dangrie158/NixieClock/Hardware/FrontPanel-IN14.brd

## EAGLE design Hardware/FrontPanel-IN14.brd (2020-01-01)

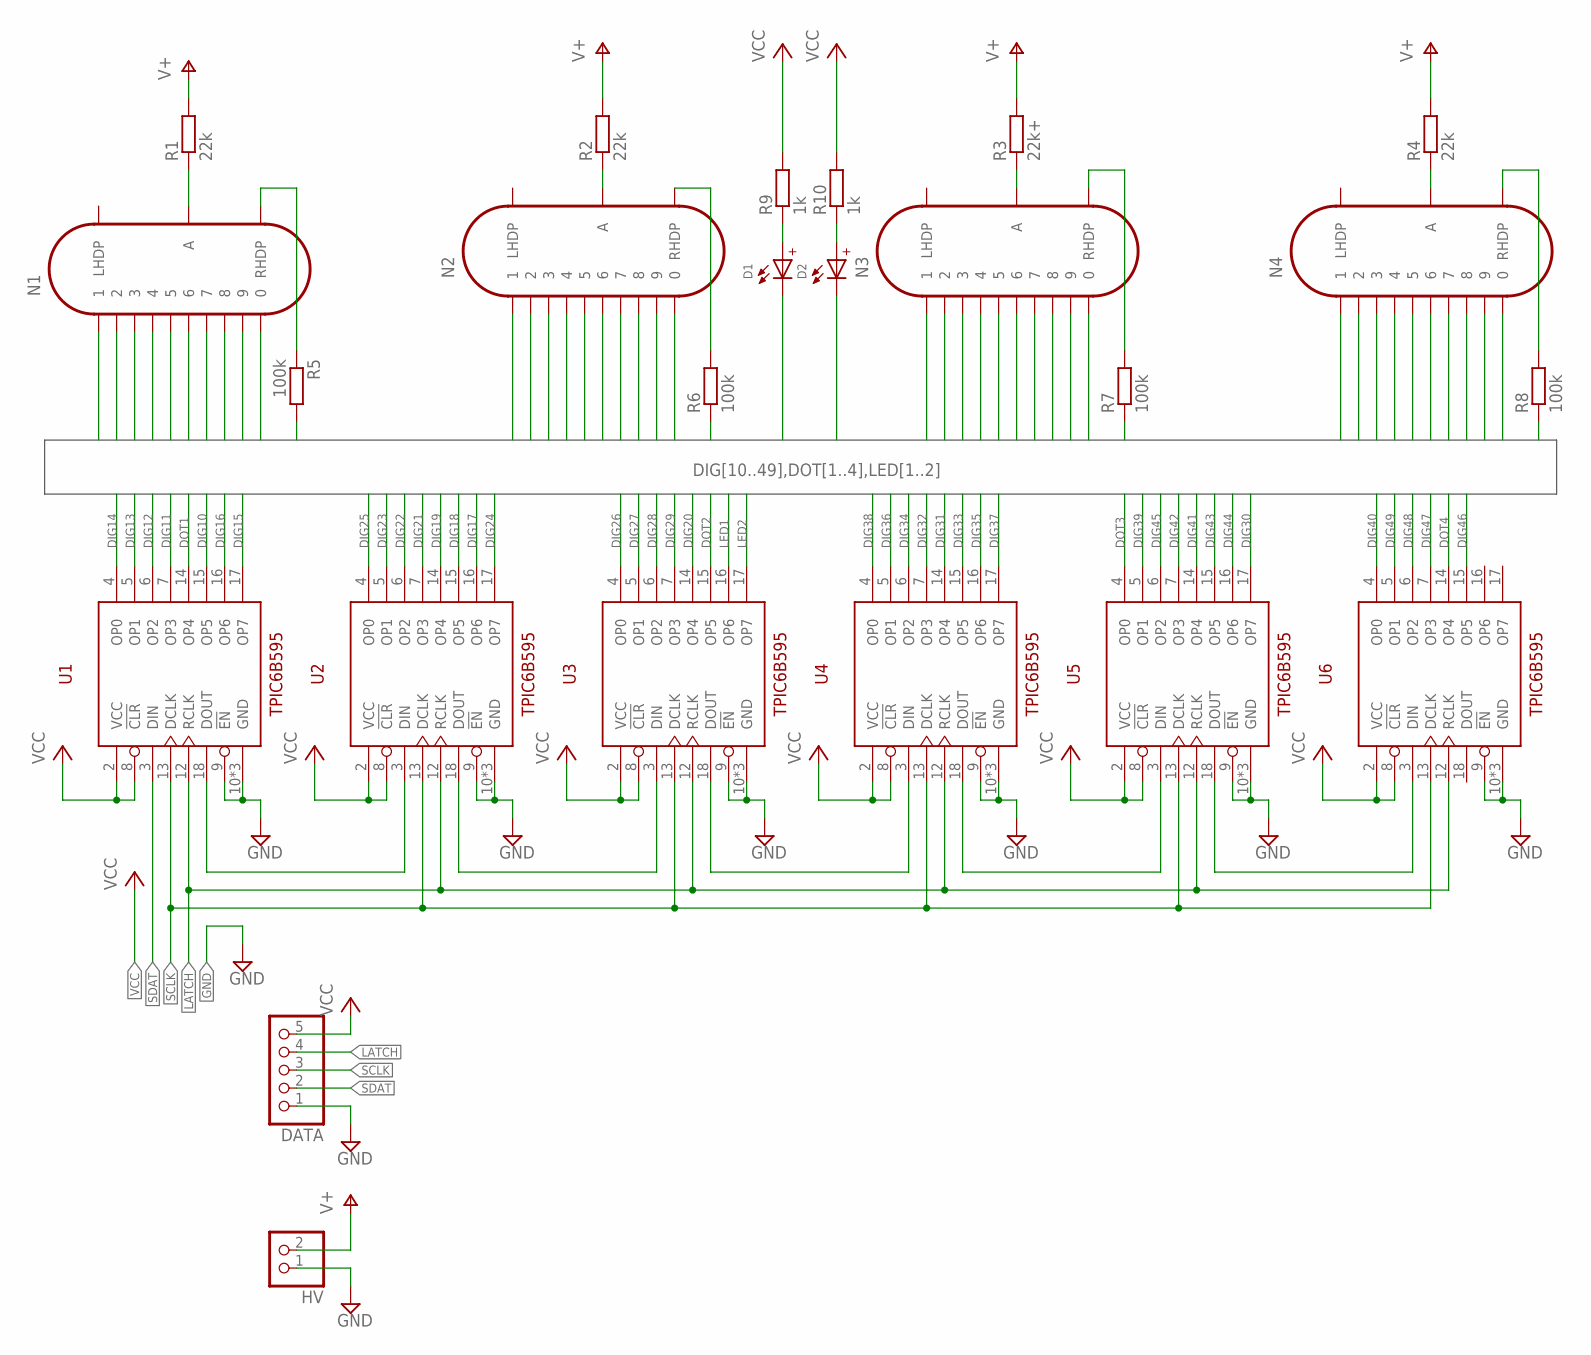
[picture p1: schematic FrontPanel-IN14.sch]

Parts:
D1, D2: RED/AMBER; WL-SITW_154141XXBA210
DATA: .1" Header; 1X05
HV: .1" Header; 1X02
N1, N2, N3, N4: IN-14
R1, R2, R4: 22k; 0207/10
R3: 22k+; 0207/10
R5, R6, R7, R8: 100k; 0207/10
R9, R10: 1k; 0207/10
U1, U2, U3, U4, U5, U6: TPIC6B595N; PDIP-20

Connections:
DIG10: N1.0, U1.15 (OP5)
DIG11: N1.1, U1.7 (OP3)
DIG12: N1.2, U1.6 (OP2)
DIG13: N1.3, U1.5 (OP1)
DIG14: N1.4, U1.4 (OP0)
DIG15: N1.5, U1.17 (OP7)
DIG16: N1.6, U1.16 (OP6)
DIG17: N1.7, U2.16 (OP6)
DIG18: N1.8, U2.15 (OP5)
DIG19: N1.9, U2.14 (OP4)
DIG20: N2.0, U3.14 (OP4)
DIG21: N2.1, U2.7 (OP3)
DIG22: N2.2, U2.6 (OP2)
DIG23: N2.3, U2.5 (OP1)
DIG24: N2.4, U2.17 (OP7)
DIG25: N2.5, U2.4 (OP0)
DIG26: N2.6, U3.4 (OP0)
DIG27: N2.7, U3.5 (OP1)
DIG28: N2.8, U3.6 (OP2)
DIG29: N2.9, U3.7 (OP3)
DIG30: N3.0, U5.17 (OP7)
DIG31: N3.1, U4.14 (OP4)
DIG32: N3.2, U4.7 (OP3)
DIG33: N3.3, U4.15 (OP5)
DIG34: N3.4, U4.6 (OP2)
DIG35: N3.5, U4.16 (OP6)
DIG36: N3.6, U4.5 (OP1)
DIG37: N3.7, U4.17 (OP7)
DIG38: N3.8, U4.4 (OP0)
DIG39: N3.9, U5.5 (OP1)
DIG40: N4.0, U6.4 (OP0)
DIG41: N4.1, U5.14 (OP4)
DIG42: N4.2, U5.7 (OP3)
DIG43: N4.3, U5.15 (OP5)
DIG44: N4.4, U5.16 (OP6)
DIG45: N4.5, U5.6 (OP2)
DIG46: N4.6, U6.15 (OP5)
DIG47: N4.7, U6.7 (OP3)
DIG48: N4.8, U6.6 (OP2)
DIG49: N4.9, U6.5 (OP1)
DOT1: R5.2, U1.14 (OP4)
DOT2: R6.1, U3.15 (OP5)
DOT3: R7.1, U5.4 (OP0)
DOT4: R8.1, U6.14 (OP4)
GND: DATA.1, HV.1, U1.9 (!EN), U1.10 (GND), U1.11 (GND), U1.19 (GND), U2.9 (!EN), U2.10 (GND), U2.11 (GND), U2.19 (GND), U3.9 (!EN), U3.10 (GND), U3.11 (GND), U3.19 (GND), U4.9 (!EN), U4.10 (GND), U4.11 (GND), U4.19 (GND), U5.9 (!EN), U5.10 (GND), U5.11 (GND), U5.19 (GND), U6.9 (!EN), U6.10 (GND), U6.11 (GND), U6.19 (GND)
LATCH: DATA.4, U1.12 (RCLK), U2.12 (RCLK), U3.12 (RCLK), U4.12 (RCLK), U5.12 (RCLK), U6.12 (RCLK)
LED1: D1.2 (-), U3.16 (OP6)
LED2: D2.2 (-), U3.17 (OP7)
unnamed: N1.RHDP, R5.1
unnamed: N2.RHDP, R6.2
unnamed: N3.RHDP, R7.2
unnamed: N4.RHDP, R8.2
unnamed: N1.A, R1.1
unnamed: N2.A, R2.1
unnamed: N3.A, R3.1
unnamed: N4.A, R4.1
unnamed: U1.18 (DOUT), U2.3 (DIN)
unnamed: U2.18 (DOUT), U3.3 (DIN)
unnamed: U3.18 (DOUT), U4.3 (DIN)
unnamed: U4.18 (DOUT), U5.3 (DIN)
unnamed: U5.18 (DOUT), U6.3 (DIN)
unnamed: D1.1 (+), R9.1
unnamed: D2.1 (+), R10.1
SCLK: DATA.3, U1.13 (DCLK), U2.13 (DCLK), U3.13 (DCLK), U4.13 (DCLK), U5.13 (DCLK), U6.13 (DCLK)
SDAT: DATA.2, U1.3 (DIN)
V+: HV.2, R1.2, R2.2, R3.2, R4.2
VCC: DATA.5, R9.2, R10.2, U1.2 (VCC), U1.8 (!CLR), U2.2 (VCC), U2.8 (!CLR), U3.2 (VCC), U3.8 (!CLR), U4.2 (VCC), U4.8 (!CLR), U5.2 (VCC), U5.8 (!CLR), U6.2 (VCC), U6.8 (!CLR)

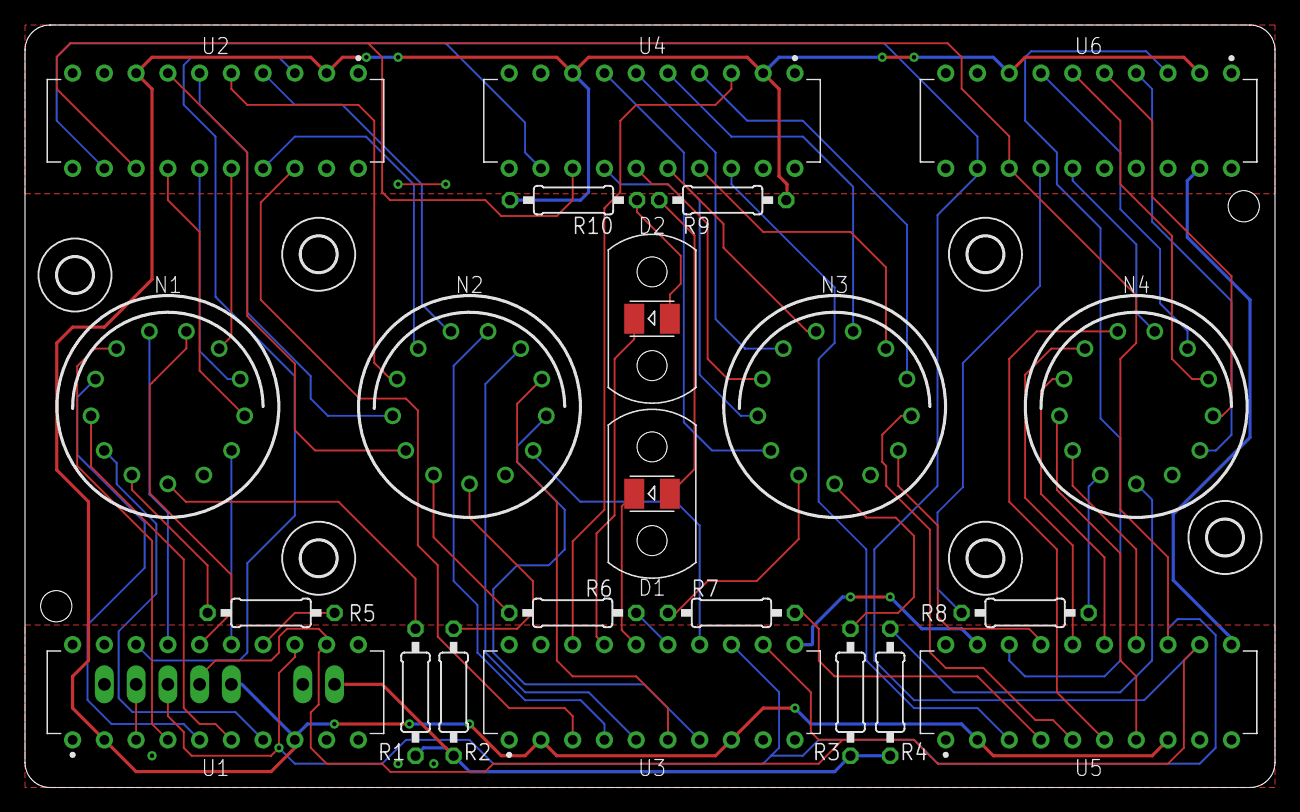
[picture p2: board FrontPanel-IN14.brd from above]

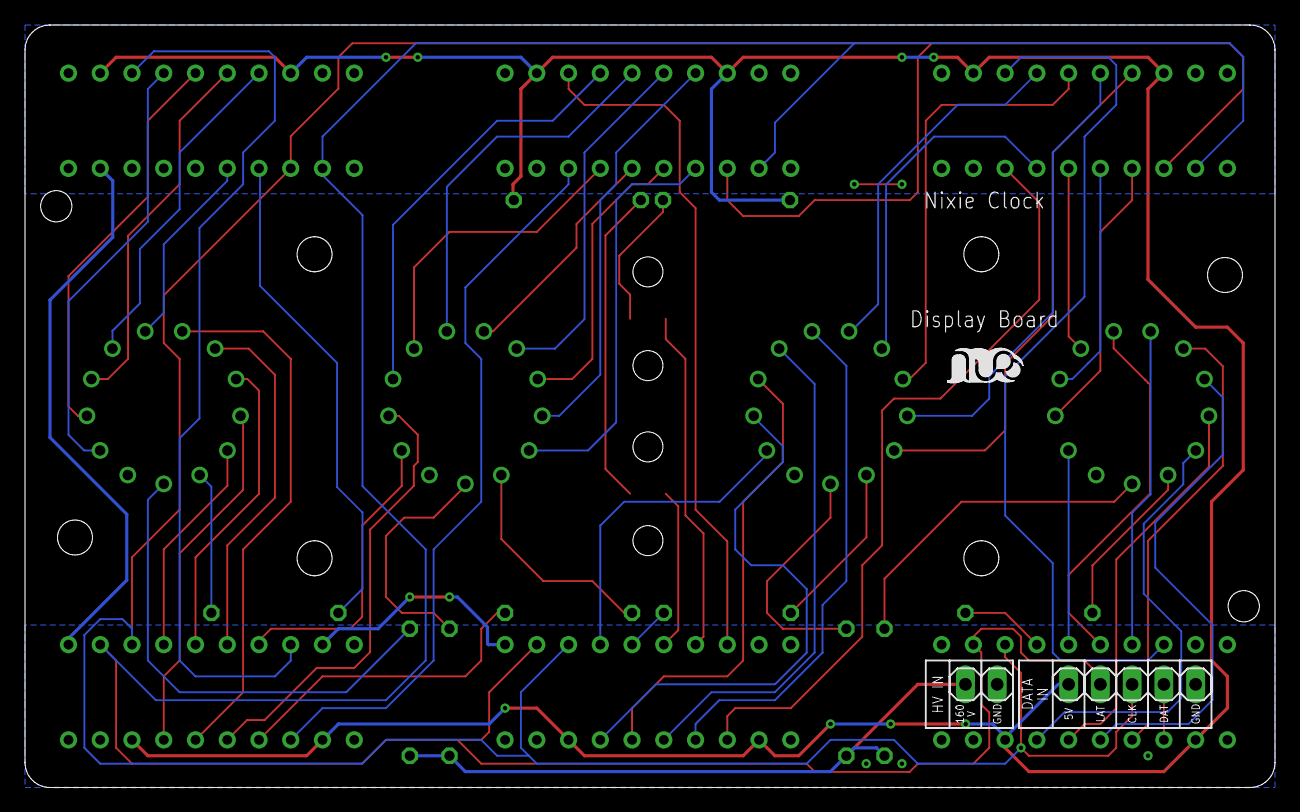
[picture p3: board FrontPanel-IN14.brd from below]

Board: 2 copper layers, 100.0 x 61.0 mm, 33 parts (3 on the bottom side), 67 nets.

Other parts of the board:
U$1, U$2, U$3, U$7, U$8, U$9: 2,8
U$4: LOGO-SILKSCREEEN-S
U$5, U$6: MENTOR-1216.1005
