dangrie158/NixieClock/Hardware/PowerSupply.brd

## EAGLE design Hardware/PowerSupply.brd (2018-12-29)

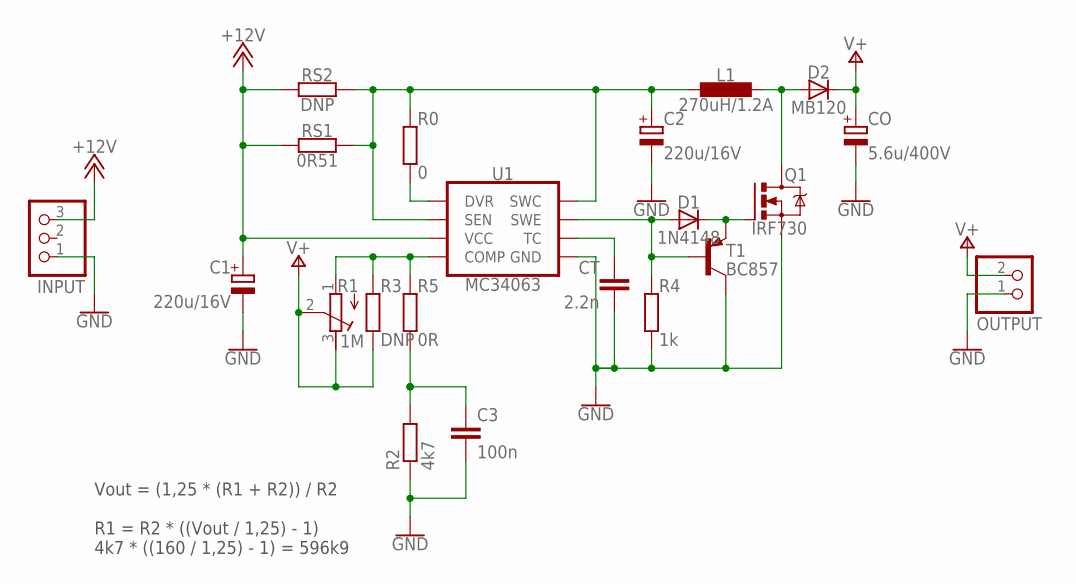
[picture p4: schematic PowerSupply.sch]

Parts:
C1, C2: 220u/16V; 140CLH-0810
C3: 100n; C0603K
CO: 5.6u/400V; 153CLV-1010
CT: 2.2n; C0603K
D1: 1N4148; SOD323-W
D2: MB120; DO214AA
INPUT: PINHD-1X3; 1X03
L1: 270uH/1.2A; TC-PIS4728
OUTPUT: PINHD-1X2; 1X02
Q1: IRF730; TO220BV
R0: 0; R0603
R1: 1M; RTRIM64W
R2: 4k7; R0603
R3: DNP; R0603
R4: 1k; R0603
R5: 0R; R0603
RS1: 0R51; R2512
RS2: DNP; R2512
T1: BC857; SOT23-BEC
U1: MC34063; SOIC127P600X175-8

Connections:
+12V: C1.+, INPUT.3, RS1.1, RS2.1, U1.6 (VCC)
GND: C1.-, C2.-, C3.2, CO.-, CT.1, INPUT.1, OUTPUT.1, Q1.S, R2.1, R4.1, T1.C, U1.4 (GND)
unnamed: D1.A, R4.2, T1.B, U1.2 (SWE)
unnamed: D1.C, Q1.G, T1.E
unnamed: R0.2, U1.8 (DVR)
unnamed: D2.A, L1.P$1 (1), Q1.D
unnamed: CT.2, U1.3 (TC)
unnamed: R1.1 (A), R3.2, R5.1, U1.5 (COMP)
unnamed: C3.1, R2.2, R5.2
unnamed: C2.+, L1.P$2 (2), R0.1, RS1.2, RS2.2, U1.1 (SWC), U1.7 (SEN)
V+: CO.+, D2.C, OUTPUT.2, R1.2 (S), R1.3 (E), R3.1

Notes on the sheet:
Vout = (1,25 * (R1 + R2)) / R2 R1 = R2 * ((Vout / 1,25) - 1) 4k7 * ((160 / 1,25) - 1) = 596k9

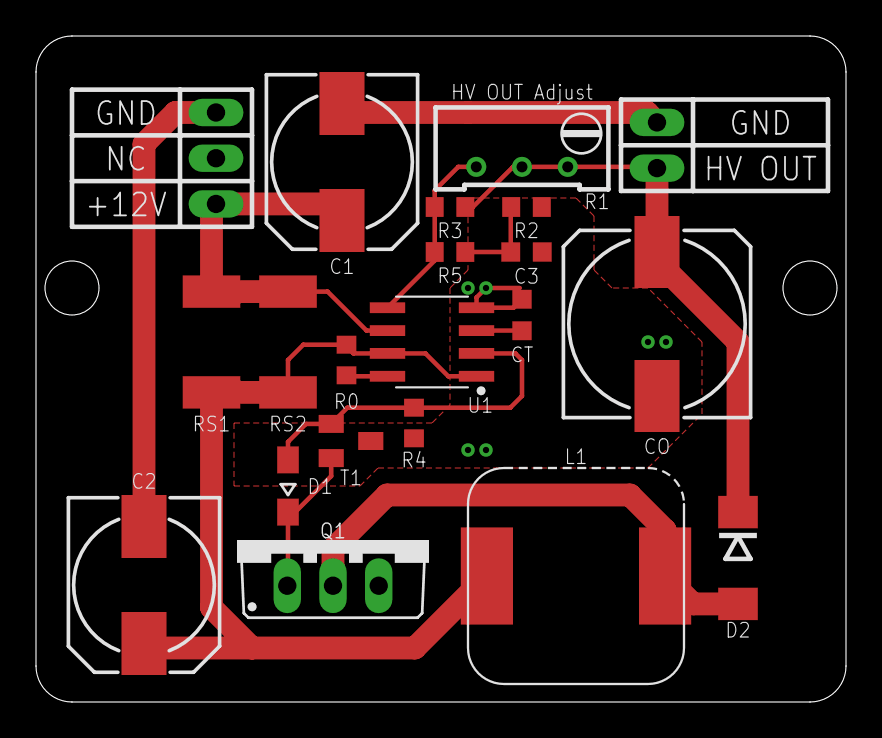
[picture p5: board PowerSupply.brd from above]

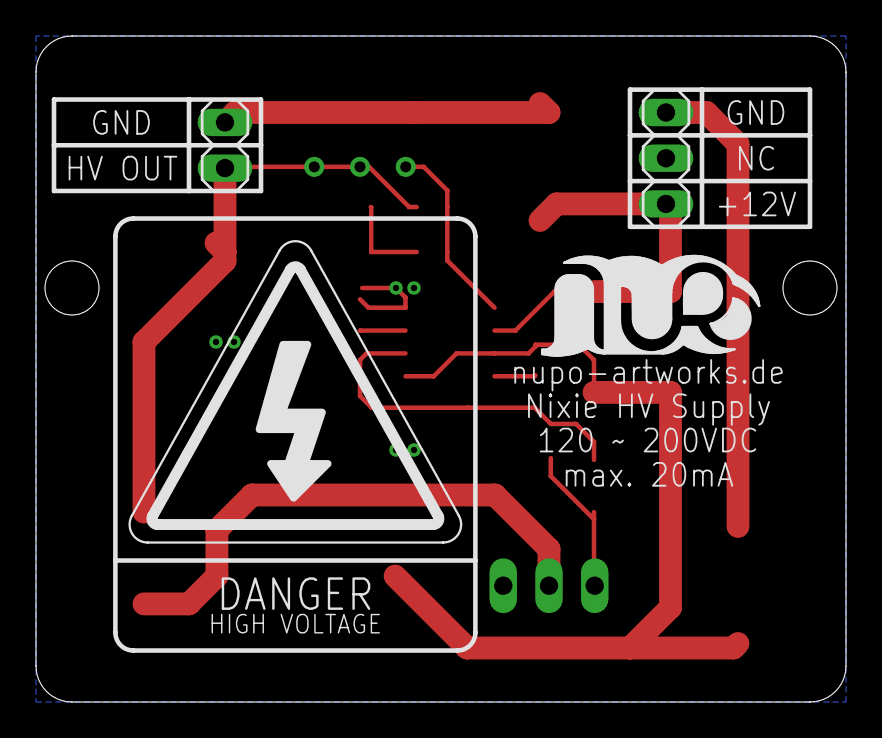
[picture p6: board PowerSupply.brd from below]

Board: 2 copper layers, 45.0 x 37.0 mm, 23 parts (4 on the bottom side), 11 nets.

Other parts of the board:
U$1: SIGN-HV
U$2: LOGO-SILKSCREEN
