dangrie158/NixieClock/Hardware/FrontPanel.brd

## EAGLE design Hardware/FrontPanel.brd (2018-12-25)

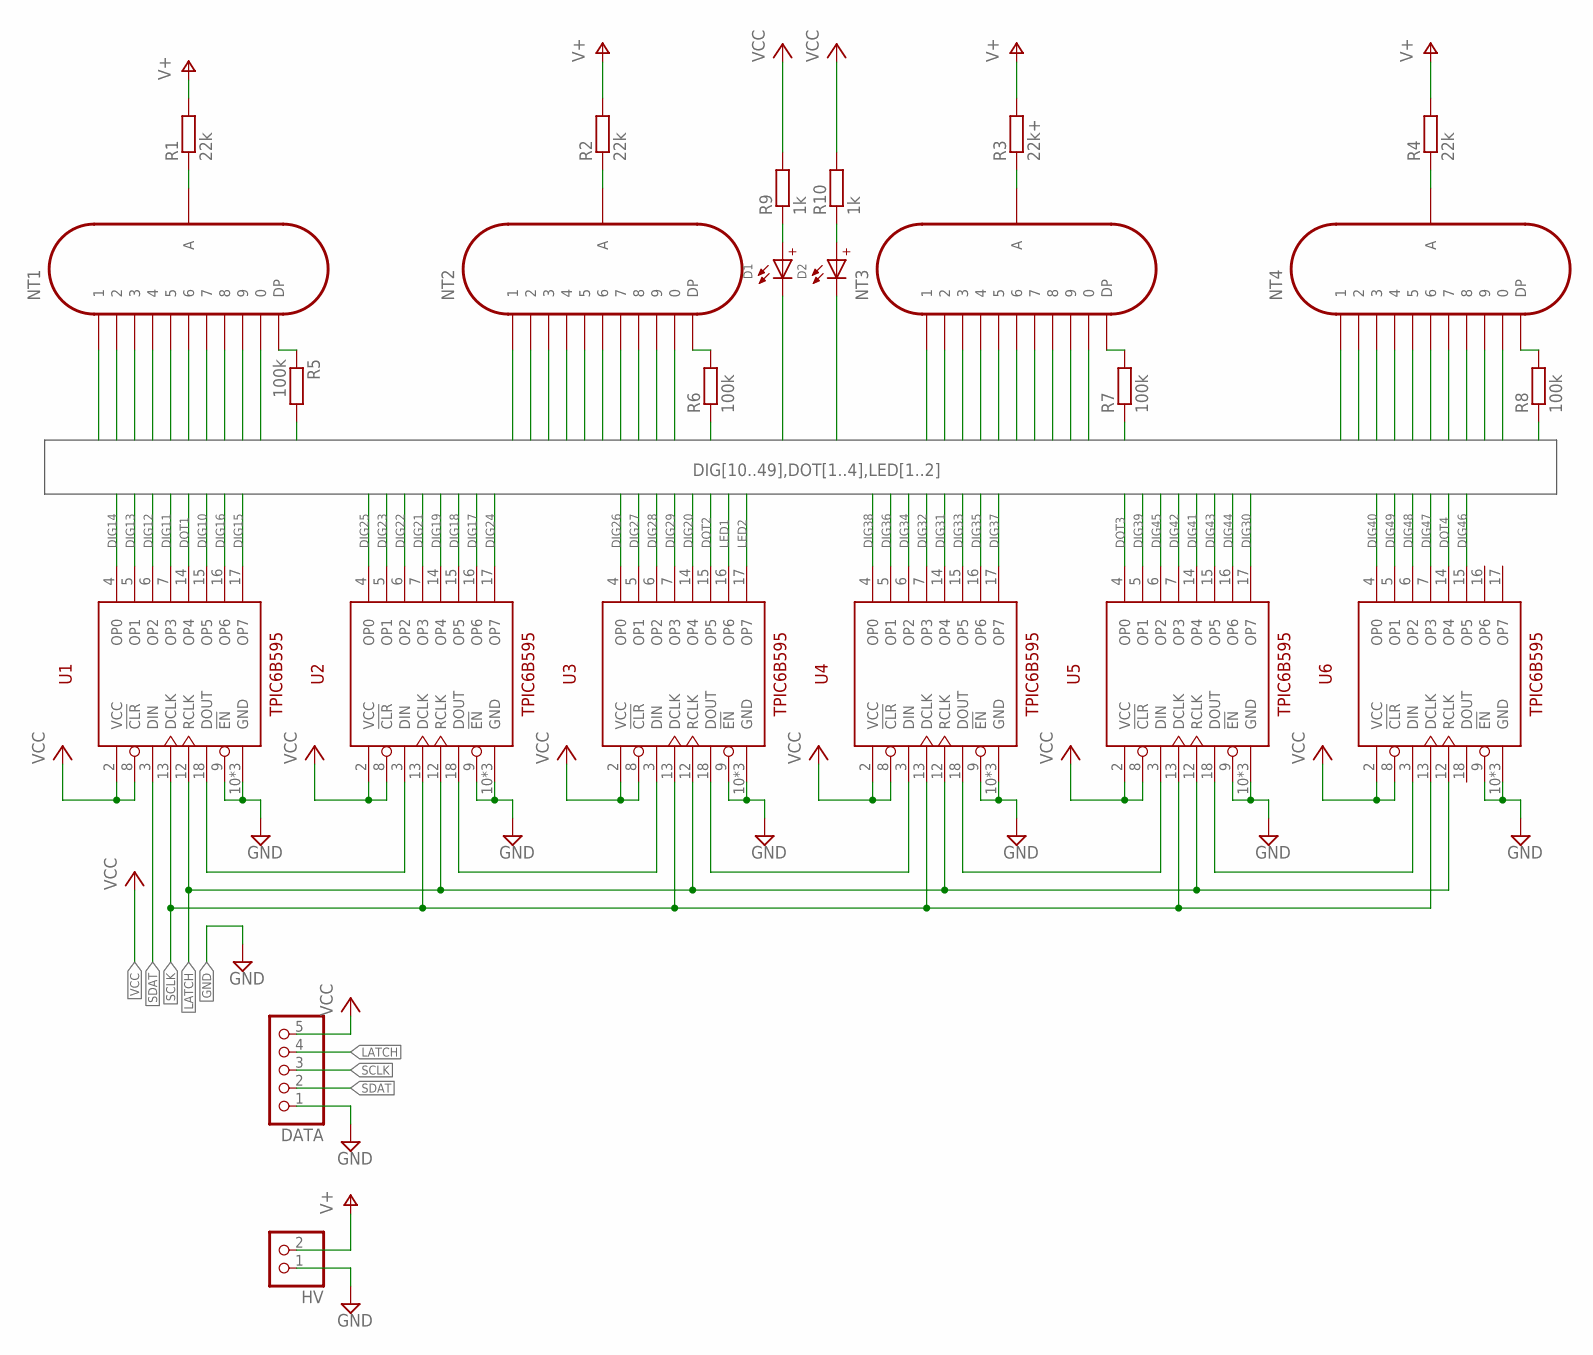
[picture p7: schematic FrontPanel.sch]

Parts:
D1, D2: RED/AMBER; WL-SITW_154141XXBA210
DATA: .1" Header; 1X05
HV: .1" Header; 1X02
NT1, NT2, NT3, NT4: IN-12B; IN-12
R1, R2, R4: 22k; 0207/10
R3: 22k+; 0207/10
R5, R6, R7, R8: 100k; 0207/10
R9, R10: 1k; 0207/10
U1, U2, U3, U4, U5, U6: TPIC6B595N; PDIP-20

Connections:
DIG10: NT1.0, U1.15 (OP5)
DIG11: NT1.1, U1.7 (OP3)
DIG12: NT1.2, U1.6 (OP2)
DIG13: NT1.3, U1.5 (OP1)
DIG14: NT1.4, U1.4 (OP0)
DIG15: NT1.5, U1.17 (OP7)
DIG16: NT1.6, U1.16 (OP6)
DIG17: NT1.7, U2.16 (OP6)
DIG18: NT1.8, U2.15 (OP5)
DIG19: NT1.9, U2.14 (OP4)
DIG20: NT2.0, U3.14 (OP4)
DIG21: NT2.1, U2.7 (OP3)
DIG22: NT2.2, U2.6 (OP2)
DIG23: NT2.3, U2.5 (OP1)
DIG24: NT2.4, U2.17 (OP7)
DIG25: NT2.5, U2.4 (OP0)
DIG26: NT2.6, U3.4 (OP0)
DIG27: NT2.7, U3.5 (OP1)
DIG28: NT2.8, U3.6 (OP2)
DIG29: NT2.9, U3.7 (OP3)
DIG30: NT3.0, U5.17 (OP7)
DIG31: NT3.1, U4.14 (OP4)
DIG32: NT3.2, U4.7 (OP3)
DIG33: NT3.3, U4.15 (OP5)
DIG34: NT3.4, U4.6 (OP2)
DIG35: NT3.5, U4.16 (OP6)
DIG36: NT3.6, U4.5 (OP1)
DIG37: NT3.7, U4.17 (OP7)
DIG38: NT3.8, U4.4 (OP0)
DIG39: NT3.9, U5.5 (OP1)
DIG40: NT4.0, U6.4 (OP0)
DIG41: NT4.1, U5.14 (OP4)
DIG42: NT4.2, U5.7 (OP3)
DIG43: NT4.3, U5.15 (OP5)
DIG44: NT4.4, U5.16 (OP6)
DIG45: NT4.5, U5.6 (OP2)
DIG46: NT4.6, U6.15 (OP5)
DIG47: NT4.7, U6.7 (OP3)
DIG48: NT4.8, U6.6 (OP2)
DIG49: NT4.9, U6.5 (OP1)
DOT1: R5.2, U1.14 (OP4)
DOT2: R6.1, U3.15 (OP5)
DOT3: R7.1, U5.4 (OP0)
DOT4: R8.1, U6.14 (OP4)
GND: DATA.1, HV.1, U1.9 (!EN), U1.10 (GND), U1.11 (GND), U1.19 (GND), U2.9 (!EN), U2.10 (GND), U2.11 (GND), U2.19 (GND), U3.9 (!EN), U3.10 (GND), U3.11 (GND), U3.19 (GND), U4.9 (!EN), U4.10 (GND), U4.11 (GND), U4.19 (GND), U5.9 (!EN), U5.10 (GND), U5.11 (GND), U5.19 (GND), U6.9 (!EN), U6.10 (GND), U6.11 (GND), U6.19 (GND)
LATCH: DATA.4, U1.12 (RCLK), U2.12 (RCLK), U3.12 (RCLK), U4.12 (RCLK), U5.12 (RCLK), U6.12 (RCLK)
LED1: D1.2 (-), U3.16 (OP6)
LED2: D2.2 (-), U3.17 (OP7)
unnamed: NT1.LHDP (DP), R5.1
unnamed: NT2.LHDP (DP), R6.2
unnamed: NT3.LHDP (DP), R7.2
unnamed: NT4.LHDP (DP), R8.2
unnamed: NT1.A, R1.1
unnamed: NT2.A, R2.1
unnamed: NT3.A, R3.1
unnamed: NT4.A, R4.1
unnamed: U1.18 (DOUT), U2.3 (DIN)
unnamed: U2.18 (DOUT), U3.3 (DIN)
unnamed: U3.18 (DOUT), U4.3 (DIN)
unnamed: U4.18 (DOUT), U5.3 (DIN)
unnamed: U5.18 (DOUT), U6.3 (DIN)
unnamed: D1.1 (+), R9.1
unnamed: D2.1 (+), R10.1
SCLK: DATA.3, U1.13 (DCLK), U2.13 (DCLK), U3.13 (DCLK), U4.13 (DCLK), U5.13 (DCLK), U6.13 (DCLK)
SDAT: DATA.2, U1.3 (DIN)
V+: HV.2, R1.2, R2.2, R3.2, R4.2
VCC: DATA.5, R9.2, R10.2, U1.2 (VCC), U1.8 (!CLR), U2.2 (VCC), U2.8 (!CLR), U3.2 (VCC), U3.8 (!CLR), U4.2 (VCC), U4.8 (!CLR), U5.2 (VCC), U5.8 (!CLR), U6.2 (VCC), U6.8 (!CLR)

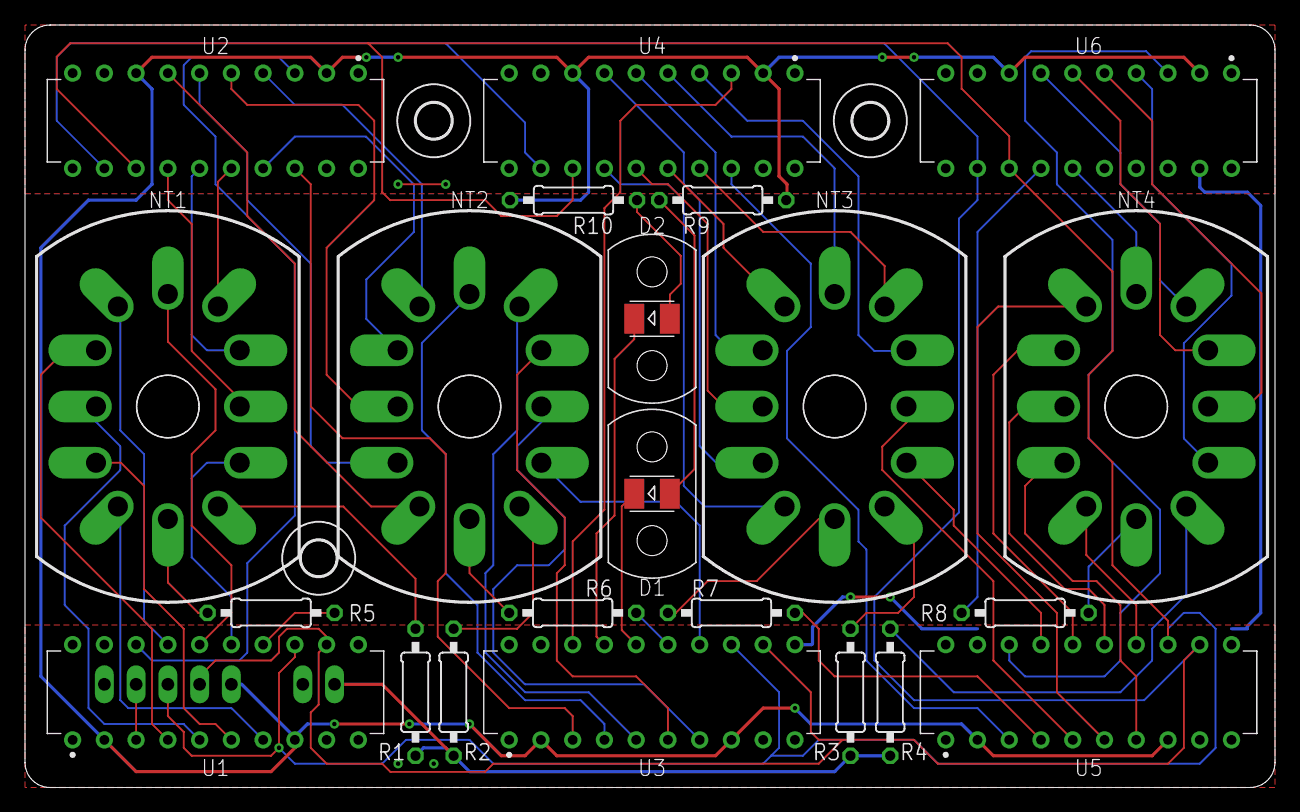
[picture p8: board FrontPanel.brd from above]

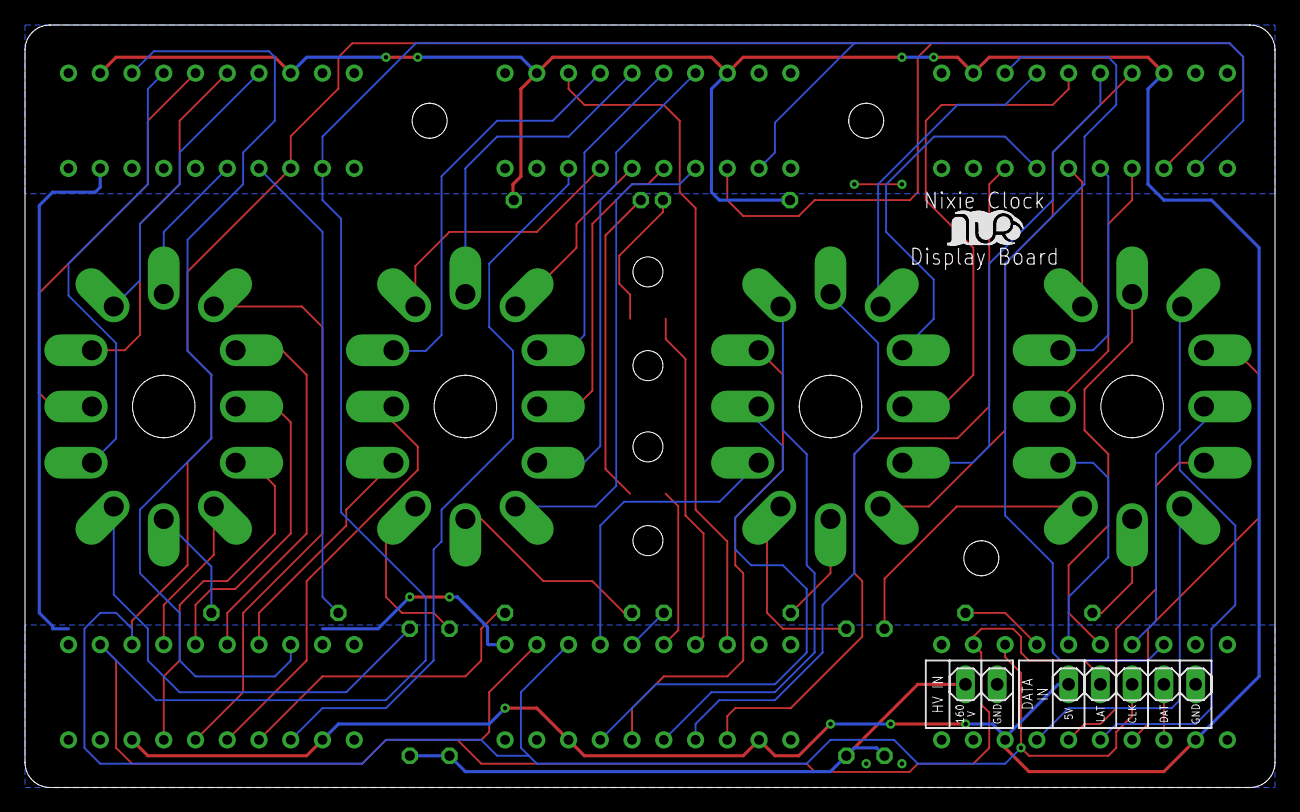
[picture p9: board FrontPanel.brd from below]

Board: 2 copper layers, 100.0 x 61.0 mm, 30 parts (3 on the bottom side), 67 nets.

Other parts of the board:
U$1, U$2, U$3: 2,8
U$4: LOGO-SILKSCREEEN-S
U$5, U$6: MENTOR-1216.1005
