dangrie158/NixieClock/Hardware/Controller.brd

## EAGLE design Hardware/Controller.brd (2018-12-18)

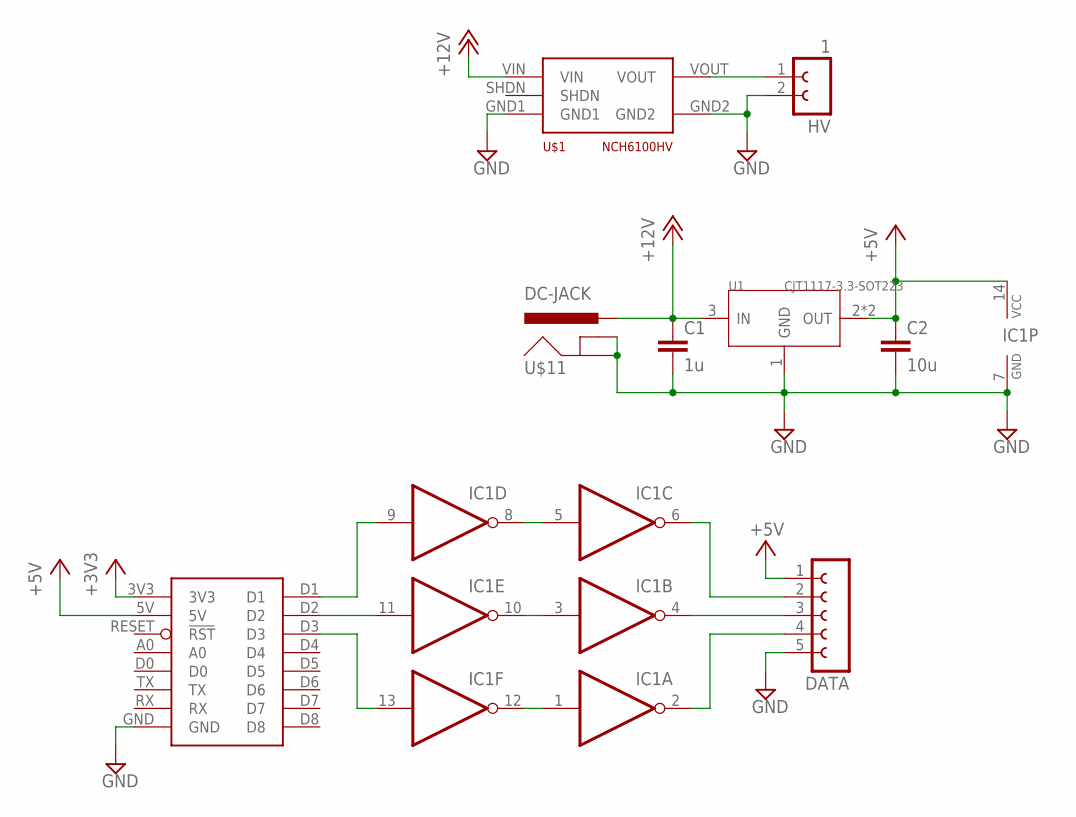
[picture p10: schematic Controller.sch]

Parts:
C1: 1u; C0603K
C2: 10u; C0603K
DATA: FE05W
HV: 1; FE02W
IC1: 74HCT04D; SO-14
U1: CJT1117-3.3-SOT223; SOT-223
U$1: NCH6100HV
U$11: DC-JACK; POWER_JACK_PTH
U$12: WEMOS-D1; WEMOS-D1-MINI

Connections:
+3V3: U$12.3V3
+5V: C2.1, DATA.1, IC1.14 (VCC), U1.2 (OUT), U1.TER (OUT), U$12.5V
+12V: C1.1, U1.3 (IN), U$1.VIN, U$11.PWR
GND: C1.2, C2.2, DATA.5, HV.2, IC1.7 (GND), U1.1 (GND), U$1.GND1, U$1.GND2, U$11.GND, U$11.GNDBREAK, U$12.GND
unnamed: HV.1, U$1.VOUT
unnamed: IC1.5 (I), IC1.8 (O)
unnamed: IC1.3 (I), IC1.10 (O)
unnamed: IC1.1 (I), IC1.12 (O)
unnamed: DATA.3, IC1.4 (O)
unnamed: IC1.13 (I), U$12.D3
unnamed: DATA.4, IC1.2 (O)
unnamed: DATA.2, IC1.6 (O)
unnamed: IC1.9 (I), U$12.D1
unnamed: IC1.11 (I), U$12.D2

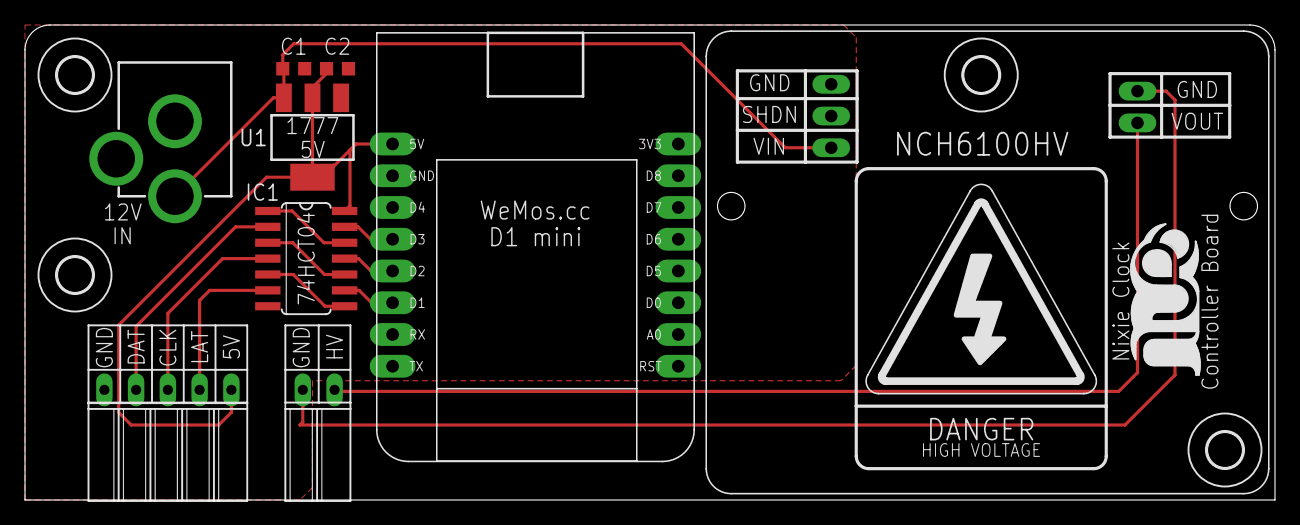
[picture p11: board Controller.brd from above]

Board: 2 copper layers, 100.0 x 38.0 mm, 14 parts (0 on the bottom side), 13 nets.

Other parts of the board:
U$2: LOGO-SILKSCREEN
U$3, U$4, U$5, U$6: 2,8
