dangrie158/NixieClock/(commit log)

2018-12-18 added second inverter stage to controller to have non-inverted logic on the outputs
    [Controller.brd, Controller.sch]
2018-12-18 switched to smd LEDs and added Light-Pipes
    [FrontPanel.brd, FrontPanel.sch]
2018-12-18 repositioned labels on connector
    [FrontPanel.brd]
2018-12-18 reduced loop area for high-voltage line
    [Controller.brd]
2018-12-18 added additional mounting hole
    [FrontPanel.brd]
2018-12-18 moved mounting hole to more accessible location
    [Controller.brd]
2018-12-18 fixed airwire in front panel and updated panel
    [FrontPanel.brd, Panel.brd]
2018-12-18 updated DC Boost Converter silkscreen
    [Controller.brd, Controller.sch, FrontPanel.brd]
2018-12-19 moved hardware files to subfolder
    [Controller.brd, Controller.sch, DC Converter Mockup.brd, DC Converter Mockup.sch, FrontPanel.brd, FrontPanel.sch, Panel.brd]
2018-12-19 added ordered gerber files
    [copper_bottom.gbr, copper_top.gbr, drills.xln, gerber_job.gbrjob, profile.gbr, silkscreen_bottom.gbr, silkscreen_top.gbr, soldermask_bottom.gbr]
2018-12-25 fixed ERC errors
    [FrontPanel.brd, FrontPanel.sch, Panel.brd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]
2018-12-29 added DC Boost Converter Module Designfiles and Simulation
    [DCDCConverter.brd, DCDCConverter.sch]
2018-12-29 renamed power supply design files
    [PowerSupply.brd, PowerSupply.sch]
2018-12-29 added power supply board gerbers
    [copper_bottom.gbr, copper_top.gbr, drills.xln, gerber_job.gbrjob, profile.gbr, silkscreen_bottom.gbr, silkscreen_top.gbr, soldermask_bottom.gbr]
2018-12-29 fixed display pin mapping and test function
    [main.cpp]
2018-12-29 fixed timezone offset problem
    [main.cpp]
2019-01-04 fixed digit pin mapping
    [main.cpp]
2019-01-06 split display function into separate parts to enable PWM dimming of the display
2020-01-01 added IN14 front panel variant
    [FrontPanel-IN14.brd, FrontPanel-IN14.sch]
2020-01-11 added lasercut cases
2020-02-01 added different pin definitions for IN-12 and IN-14 variants
2020-02-01 updated IN-14 Case to fix space issues
