dangrie158/NixieClock/(notices)

Notices in the files:
parts and their libraries:
Wurth_Elektronik_Optoelectronics_rev18a: Copyright: Würth Elektronik
